Mr-OutLaw/otto/CAD/otto+Quad_4mm_v1.0.dxf

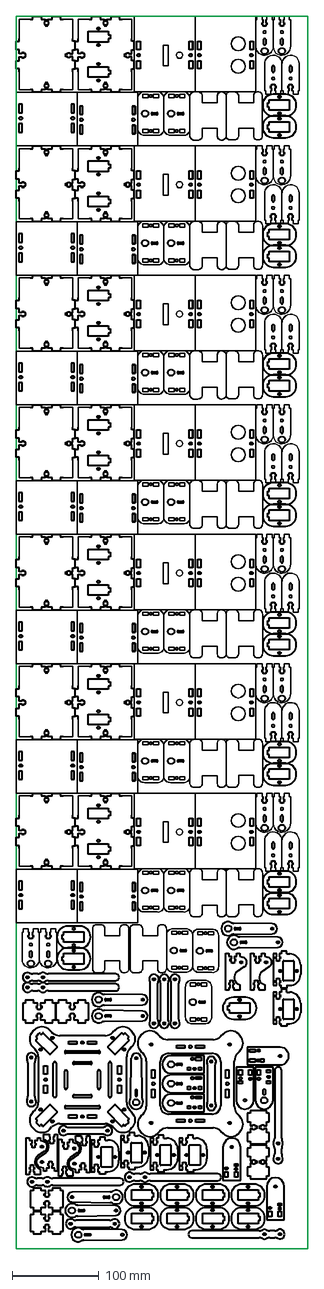
[picture p1: CAD file, 2017-09-18]
CAD/otto+Quad_4mm_v1.0.dxf
335.8 x 1420.0 mm
