Mr-OutLaw/otto/CAD/otto_4mm_v1.0.dxf

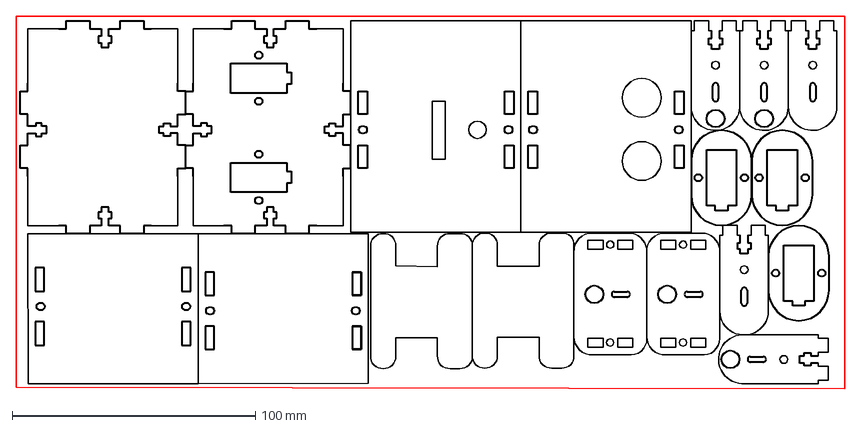
[picture p2: CAD file, 2017-09-17]
CAD/otto_4mm_v1.0.dxf
340.8 x 153.4 mm
