Mr-OutLaw/otto/CAD/otto.dxf

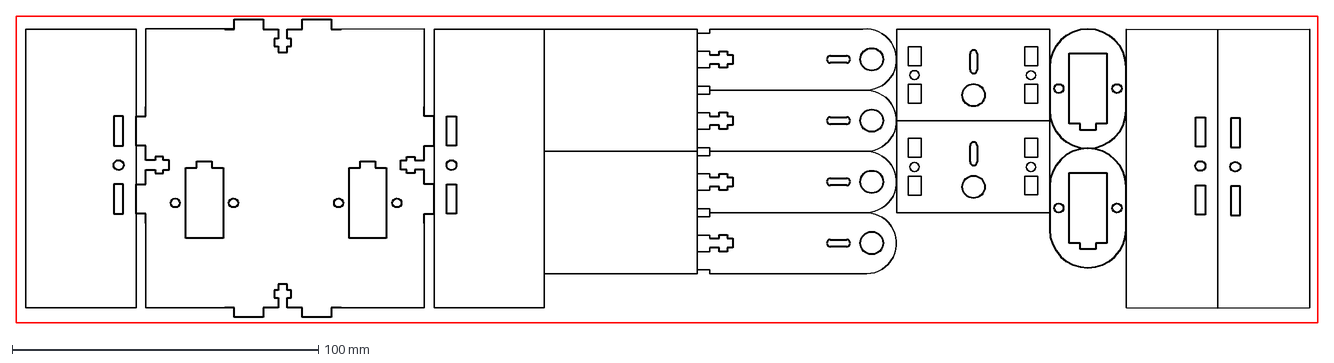
[picture p3: CAD file, 2017-09-03]
CAD/otto.dxf
425.1 x 100.0 mm
