Mr-OutLaw/otto/CAD/ott_3mmo.dxf

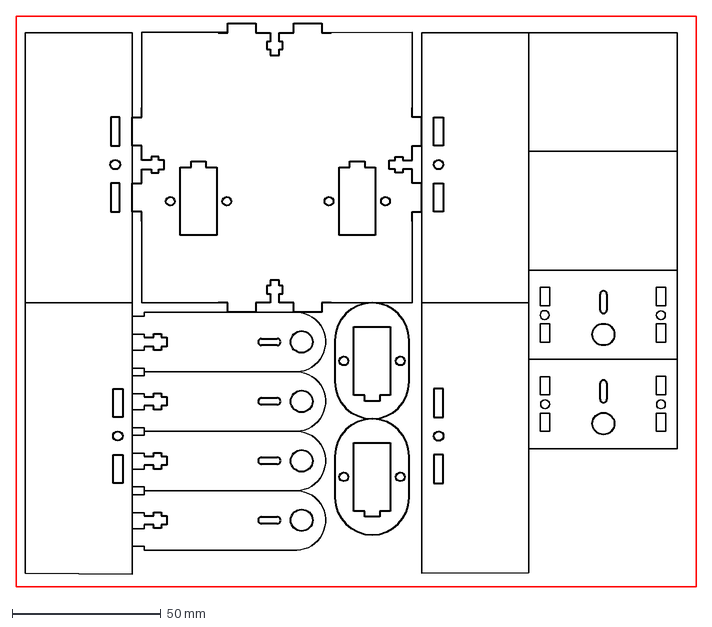
[picture p4: CAD file, 2017-09-03]
CAD/ott_3mmo.dxf
228.8 x 192.1 mm
