Mr-OutLaw/otto/OTTO+_InstructionsManual_V01_arduino.pdf

# DIY+

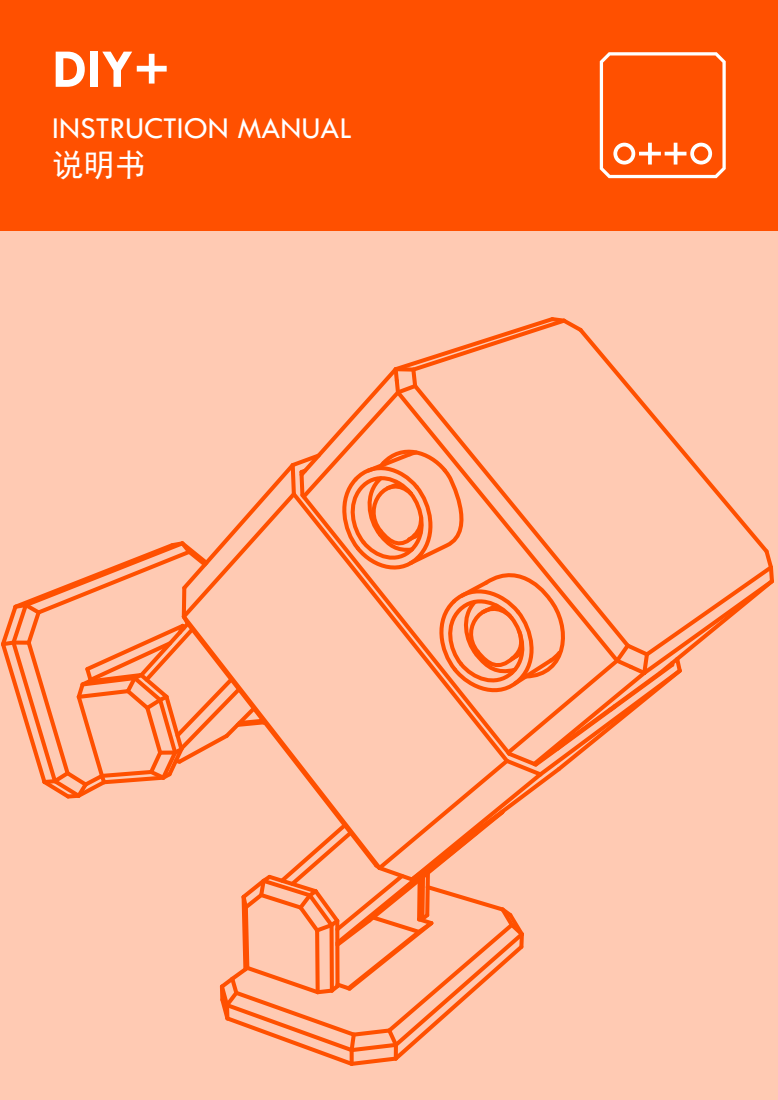
[picture p5: page 1]
INSTRUCTION MANUAL 说明书

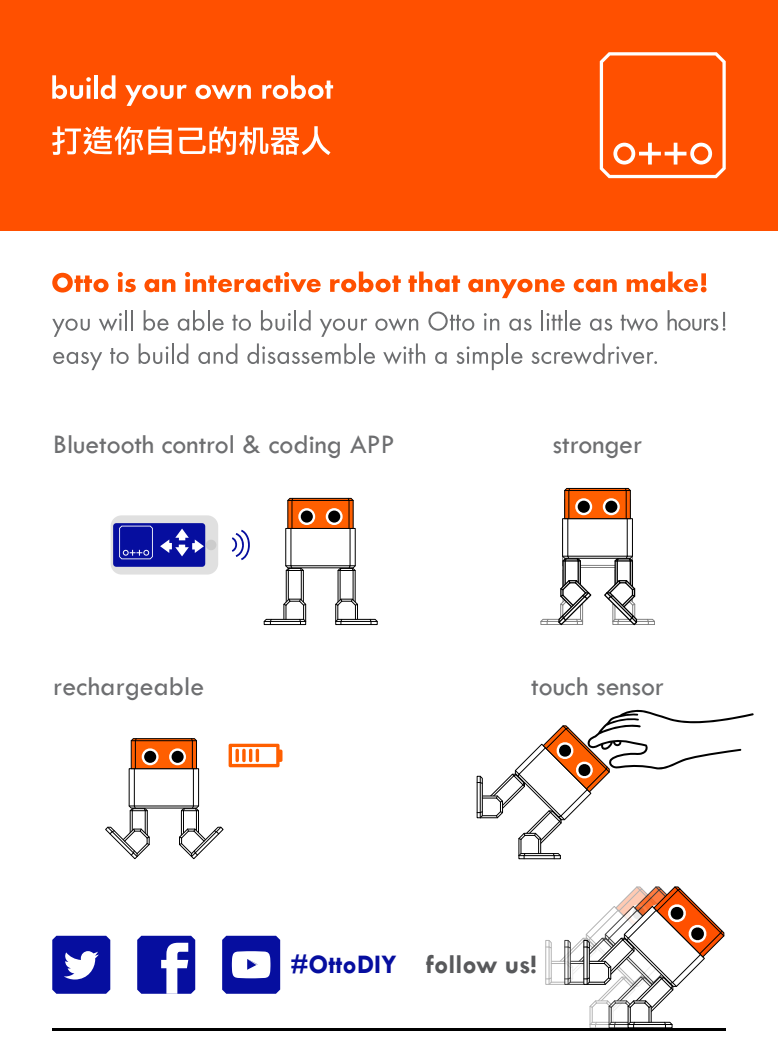
[picture p6: page 2]
rechargeable; touch sensor; stronger

Bluetooth control & coding APP

#OttoDIY follow us!

# PARTS

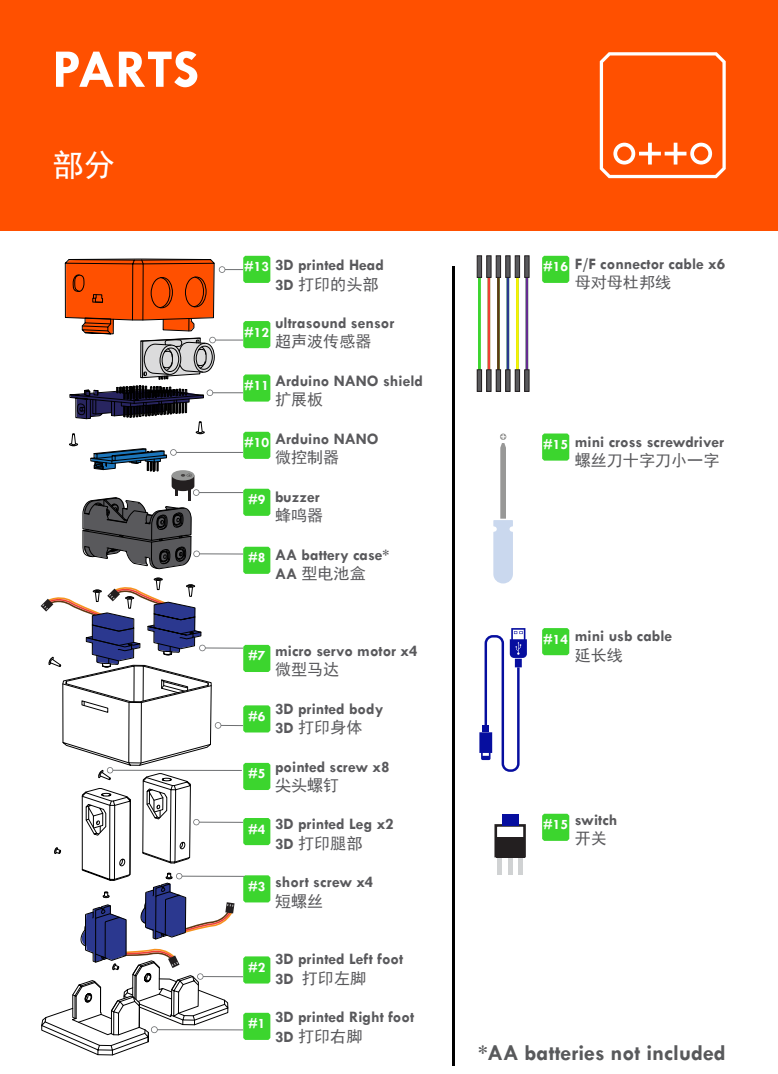
[picture p7: page 3]
#13 3D printed Head 3D 打印的头部; ultrasound sensor 超声波传感器; Arduino NANO shield 扩展板; Arduino NANO 微控制器; buzzer 蜂鸣器; micro servo motor x4 微型马达; 3D printed body 3D 打印身体; pointed screw x8 尖头螺钉; 3D printed Leg x2 3D 打印腿部; short screw x4 短螺丝; 3D printed Left foot 3D 打印左脚; #16 F/F connector cable x6 母对母杜邦线; mini cross screwdriver 螺丝刀十字刀小一字; mini usb cable 延长线; switch 开关

AA battery case*
AA 型电池盒

3D printed Right foot
3D 打印右脚 #1

*AA batteries not included

a

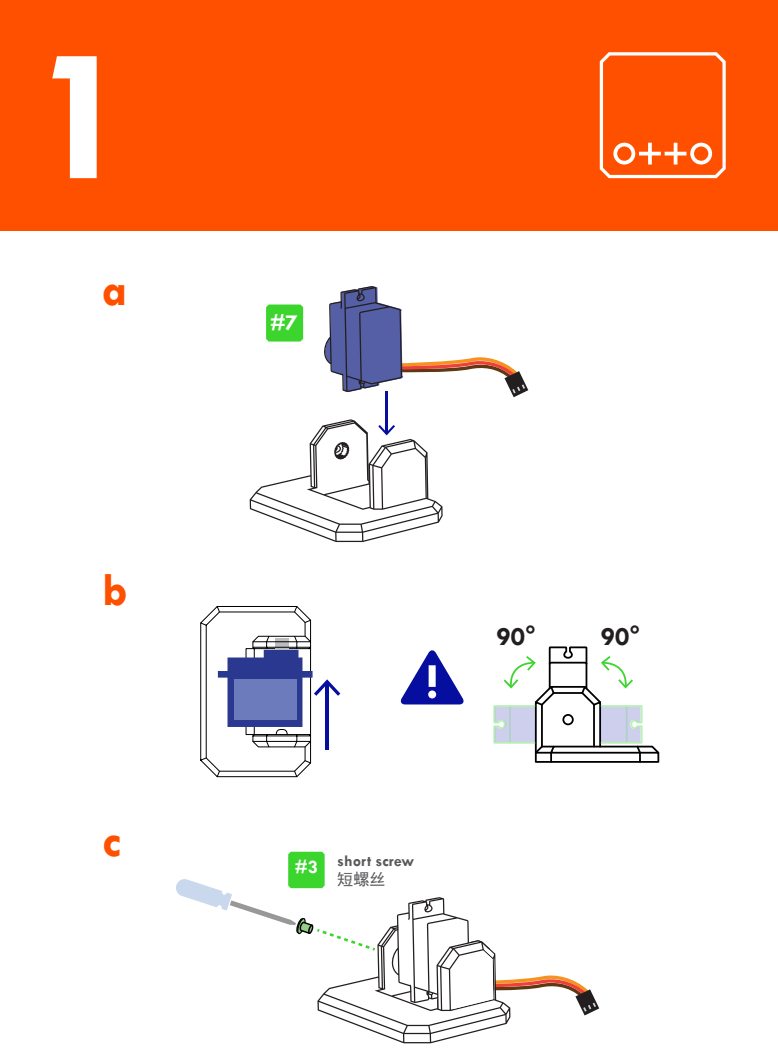
[picture p8: page 4]
short screw 短螺丝

a

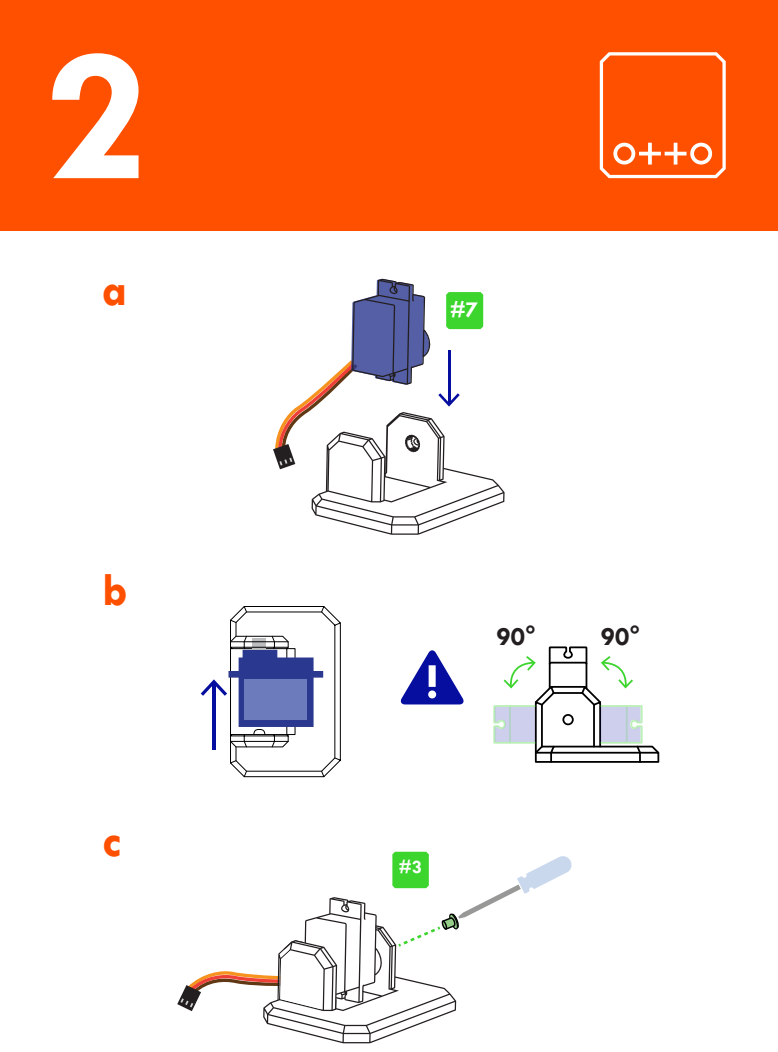
[picture p9: page 5]

a

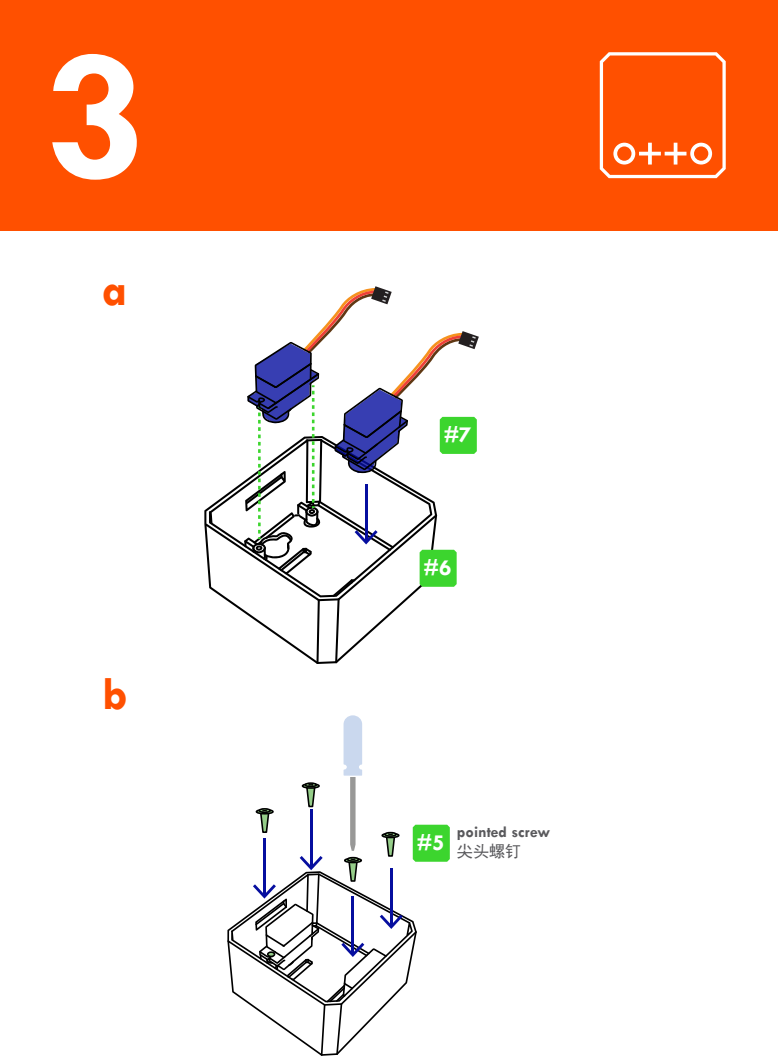
[picture p10: page 6]
#5 pointed screw 尖头螺钉

a

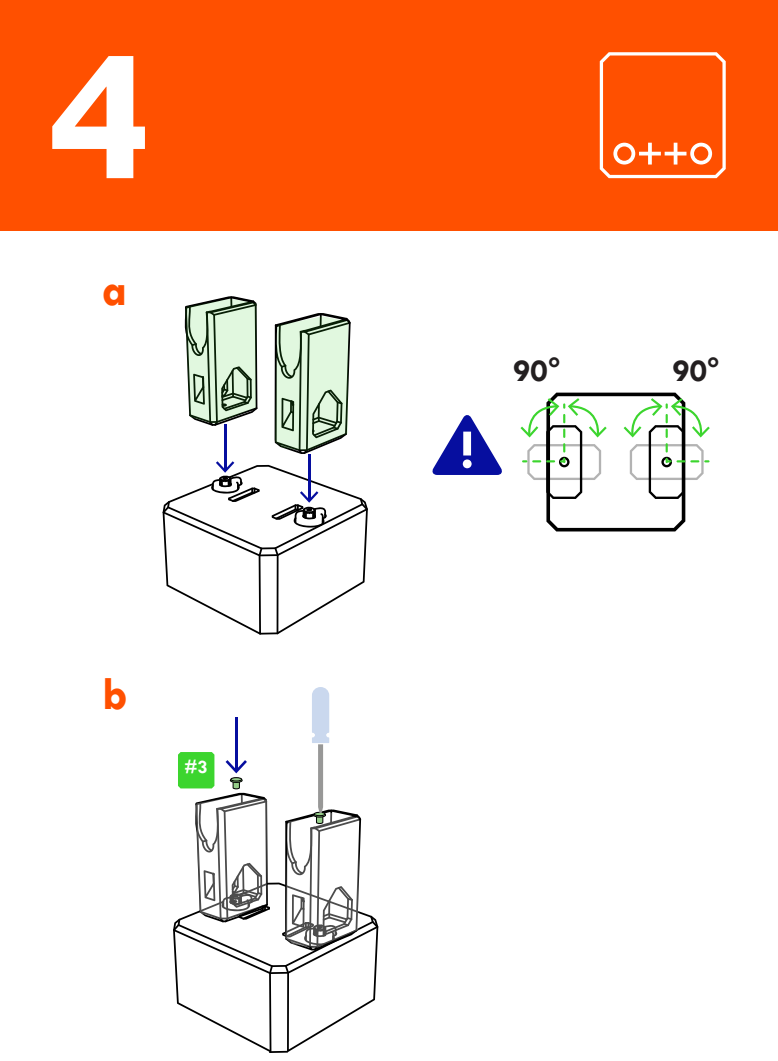
[picture p11: page 7]

ab

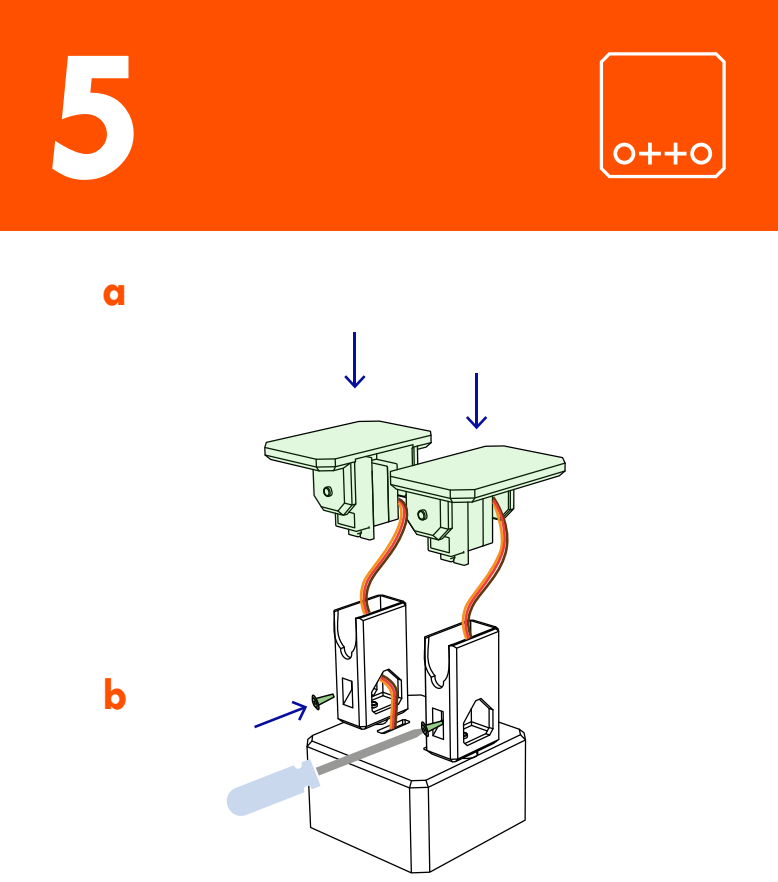
[picture p12: page 8]

ab

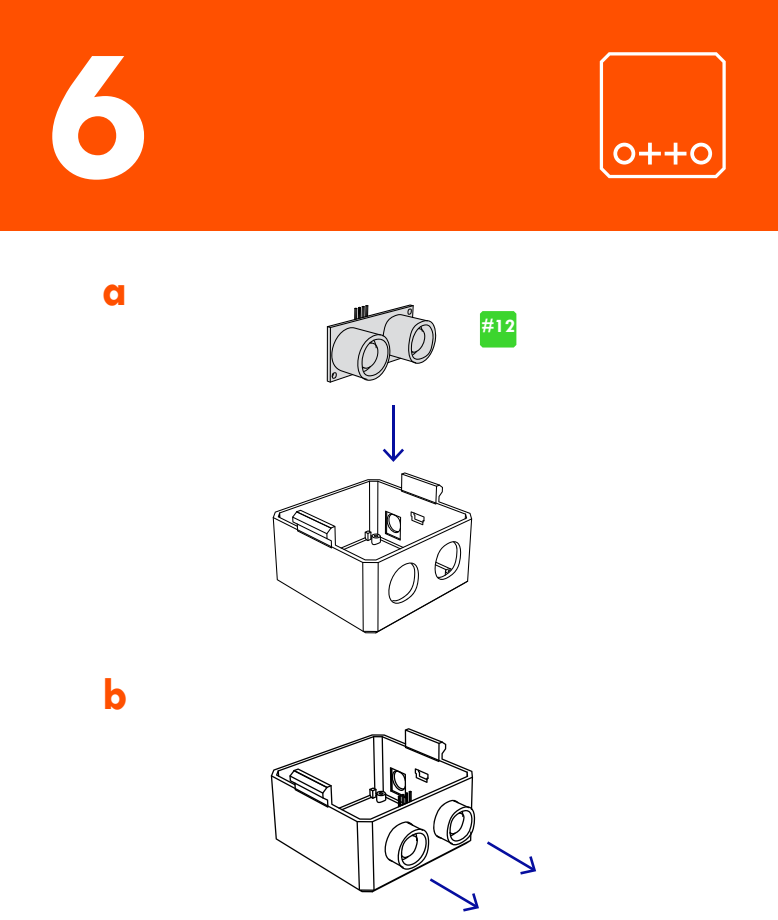
[picture p13: page 9]

ab

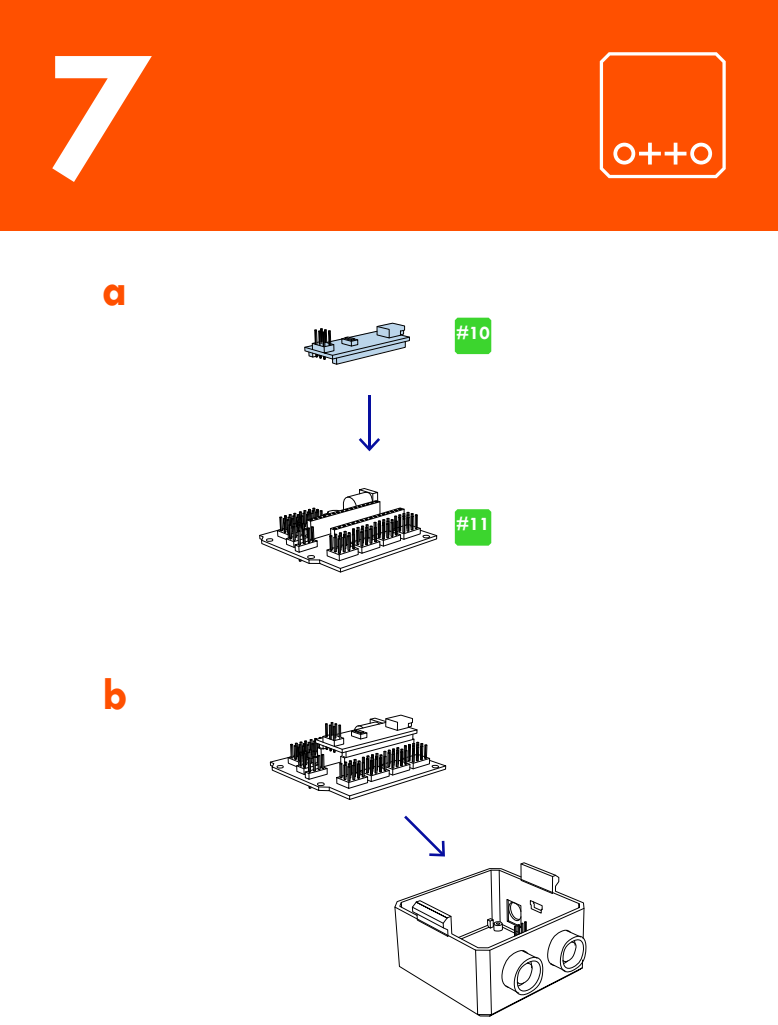
[picture p14: page 10]

ab

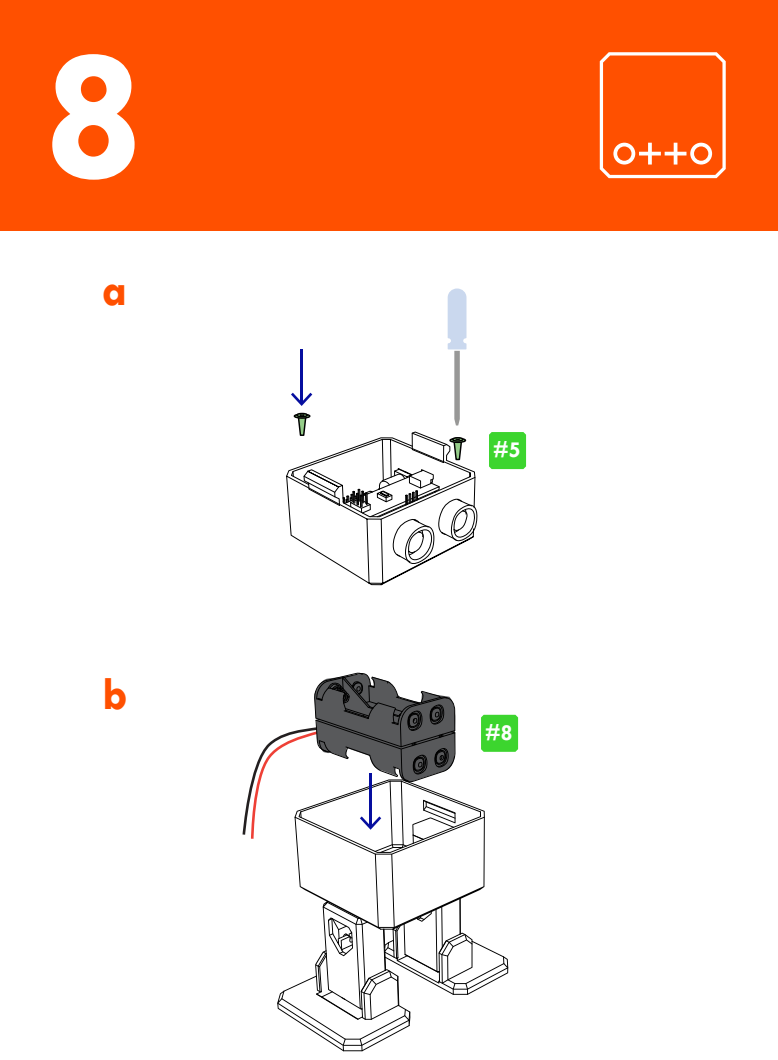
[picture p15: page 11]

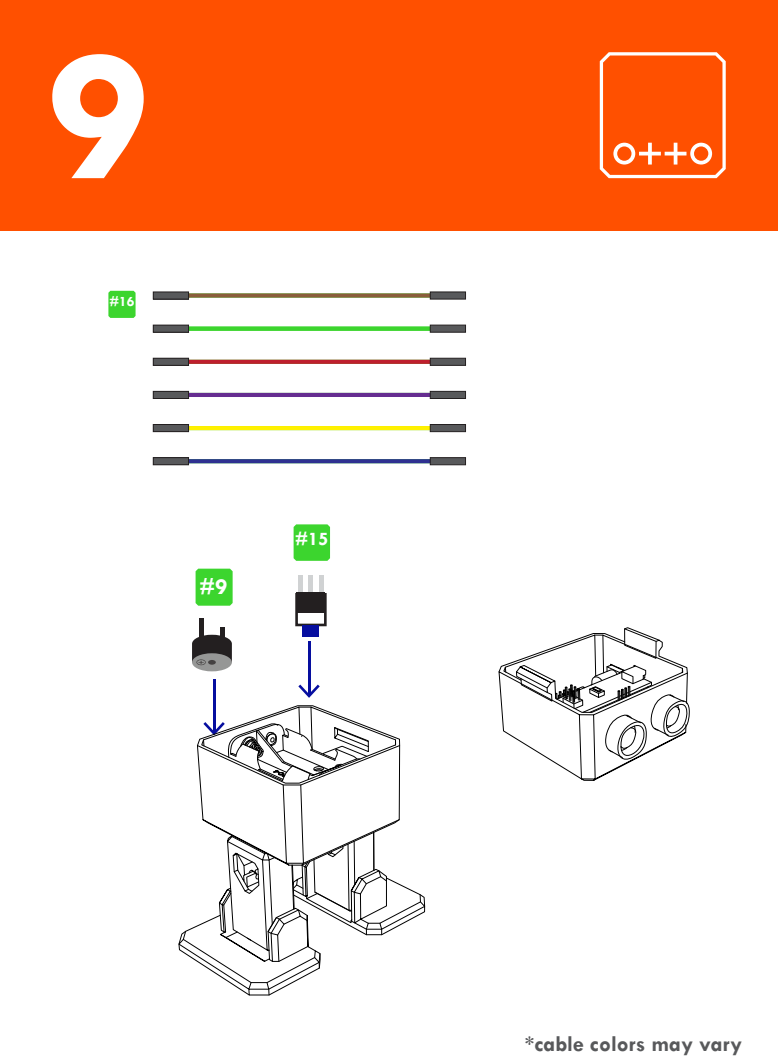
[picture p16: page 12]

*cable colors may vary

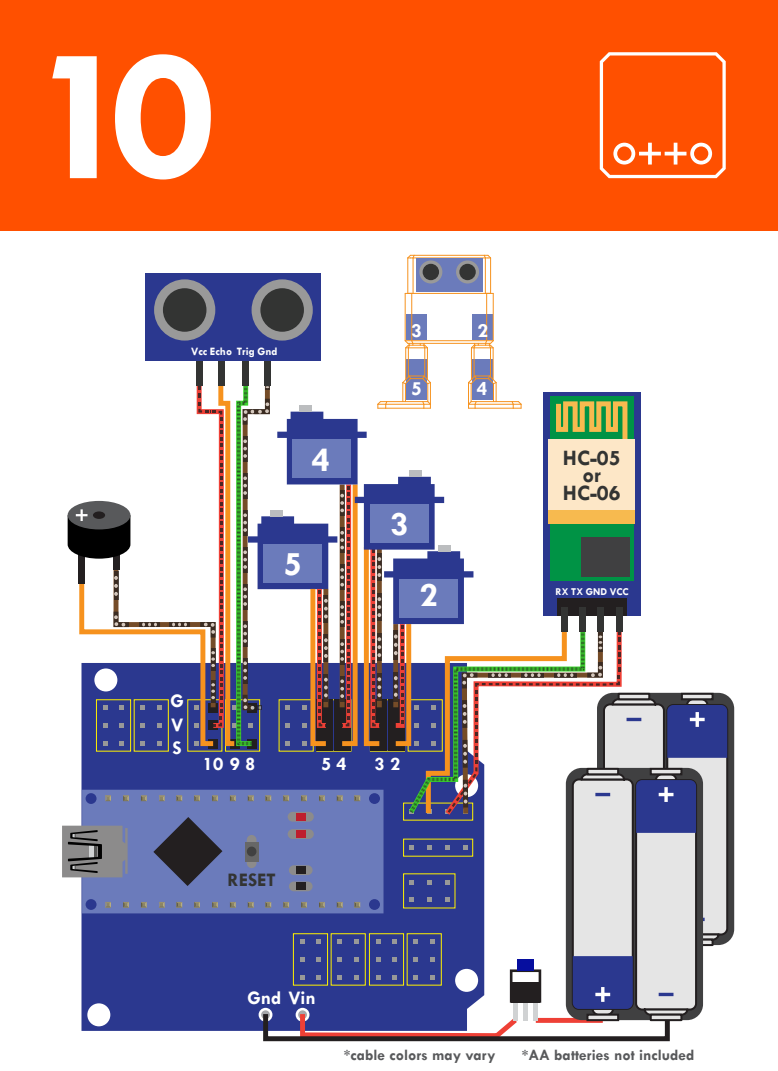
[picture p17: page 13]
RESET; Gnd Vin; *cable colors may vary; *AA batteries not included

Vcc Echo Trig Gnd

RX TX GND VCC

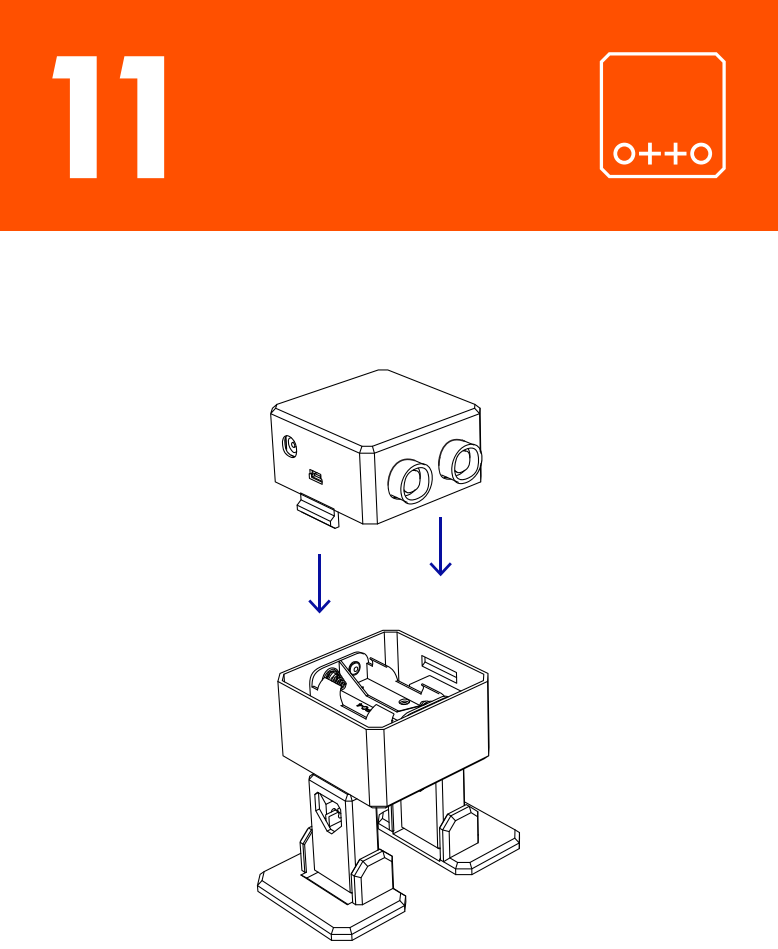
[picture p18: page 14]

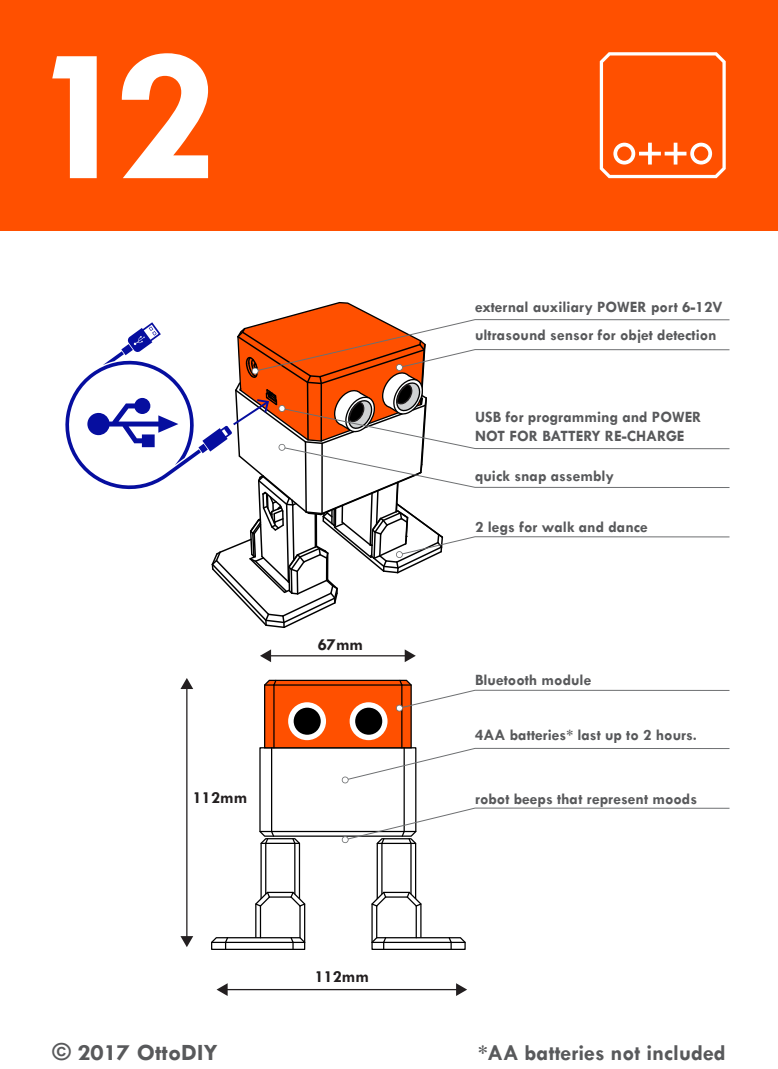
[picture p19: page 15]
Bluetooth module; © 2017 OttoDIY; *AA batteries not included

external auxiliary POWER port 6-12V
ultrasound sensor for objet detection

USB for programming and POWER
NOT FOR BATTERY RE-CHARGE

quick snap assembly

2 legs for walk and dance

4AA batteries* last up to 2 hours.

robot beeps that represent moods

# DIY+

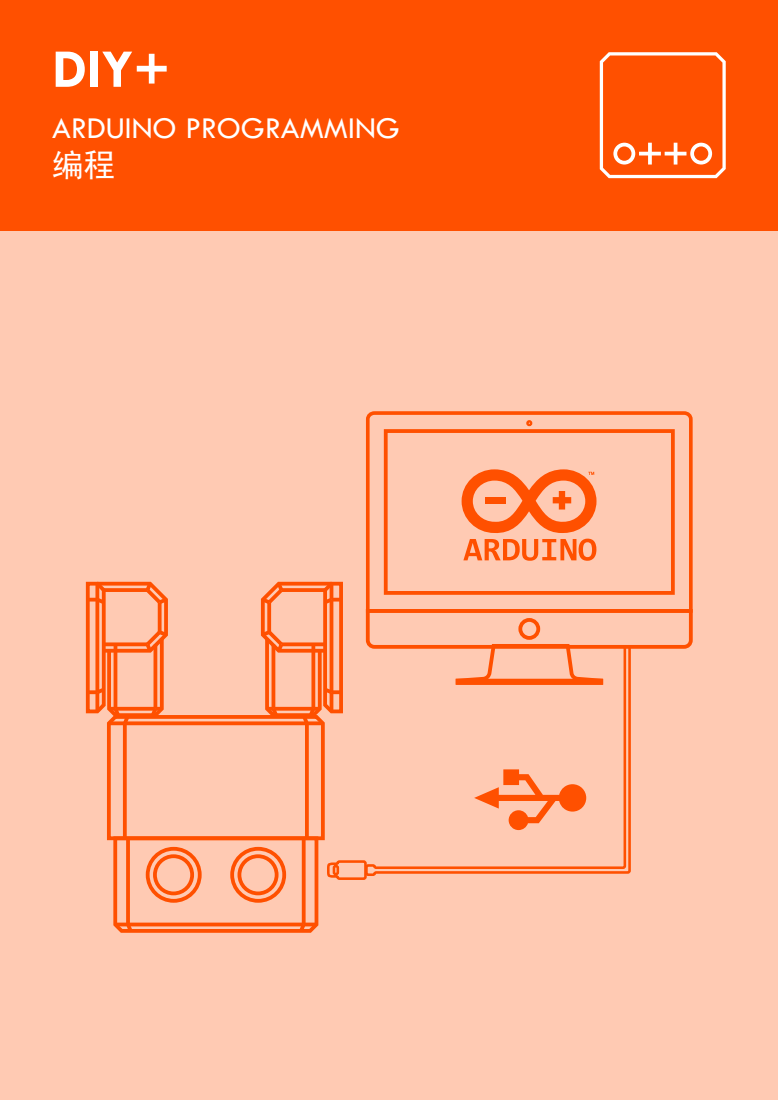
[picture p20: page 16]
ARDUINO PROGRAMMING 编程

a

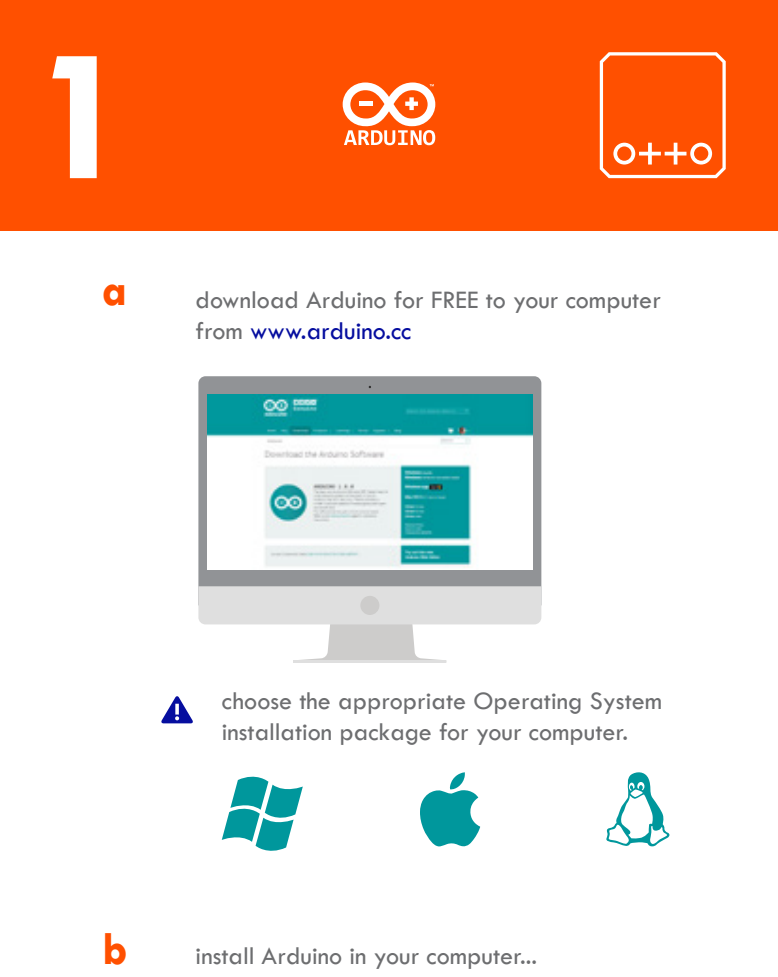
[picture p21: page 17]

download Arduino for FREE to your computer
from www.arduino.cc

choose the appropriate Operating System
installation package for your computer.

install Arduino in your computer...

a

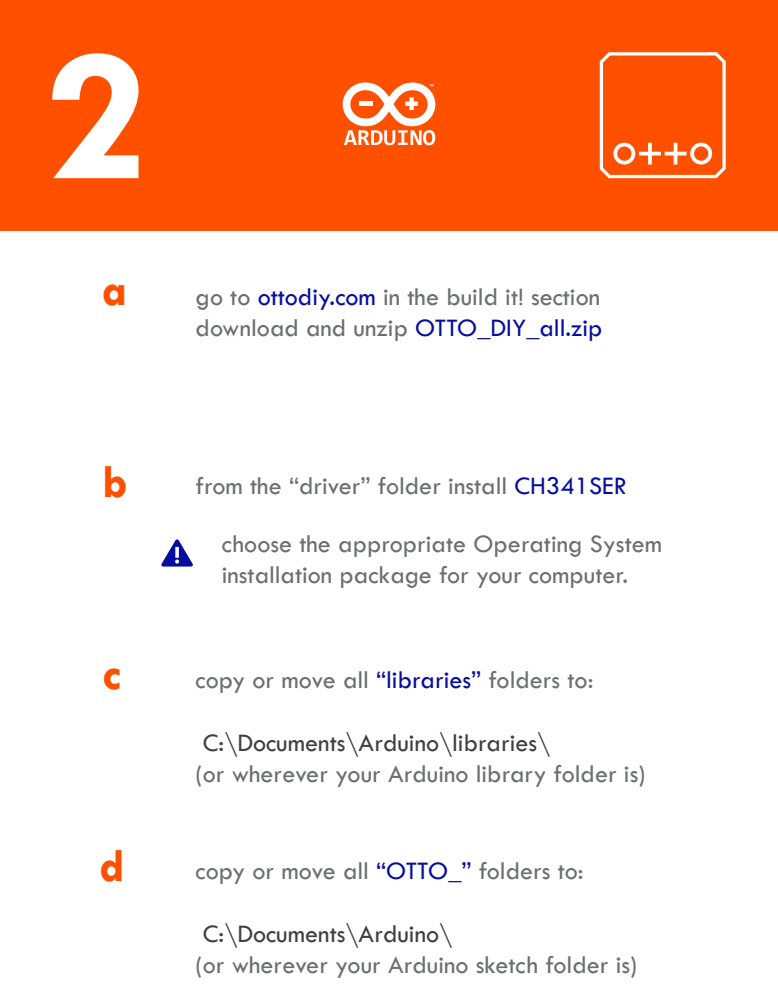
[picture p22: page 18]

go to ottodiy.com in the build it! section
download and unzip OTTO_DIY_all.zip

from the “driver” folder install CH341SER
choose the appropriate Operating System
installation package for your computer.
copy or move all “libraries” folders to:

C:\Documents\Arduino\libraries\
(or wherever your Arduino library folder is)

copy or move all “OTTO_” folders to:

C:\Documents\Arduino\
(or wherever your Arduino sketch folder is)

a

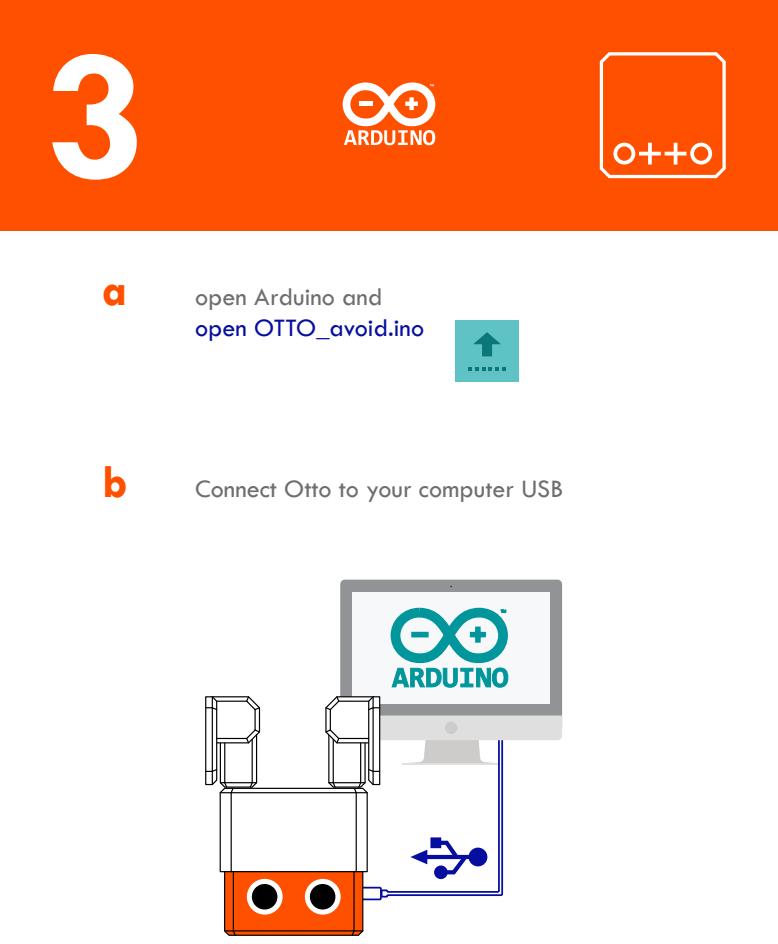
[picture p23: page 19]

open Arduino and
open OTTO_avoid.ino

Connect Otto to your computer USB

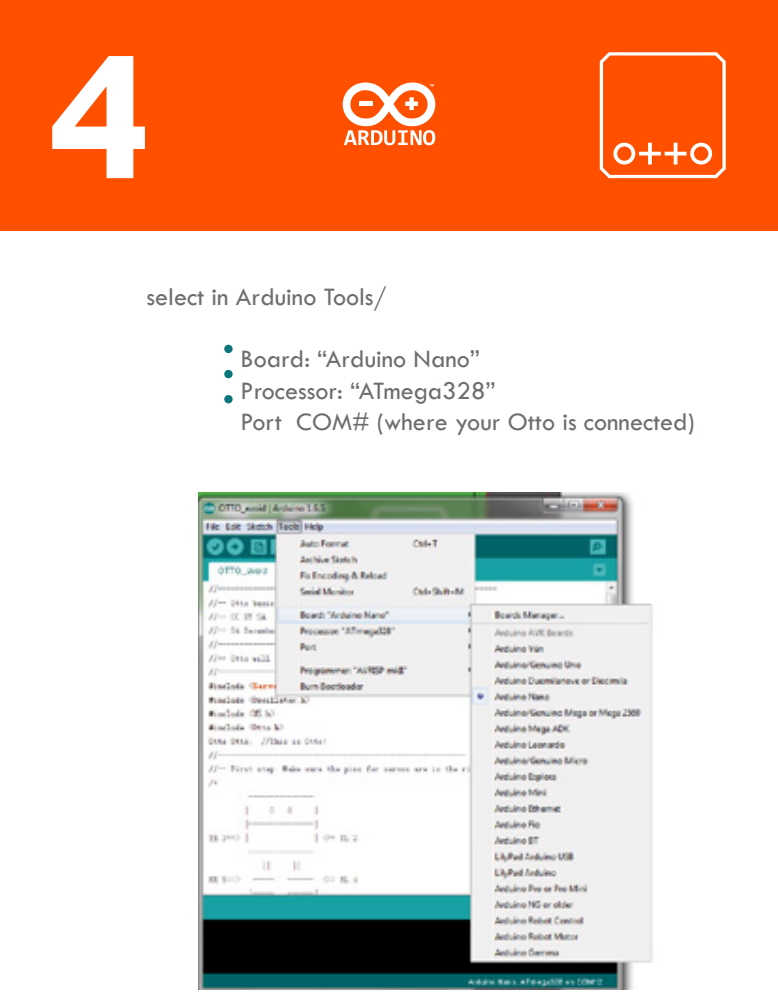
[picture p24: page 20]

select in Arduino Tools/

Board: “Arduino Nano”
Processor: “ATmega328”
Port COM# (where your Otto is connected)

a

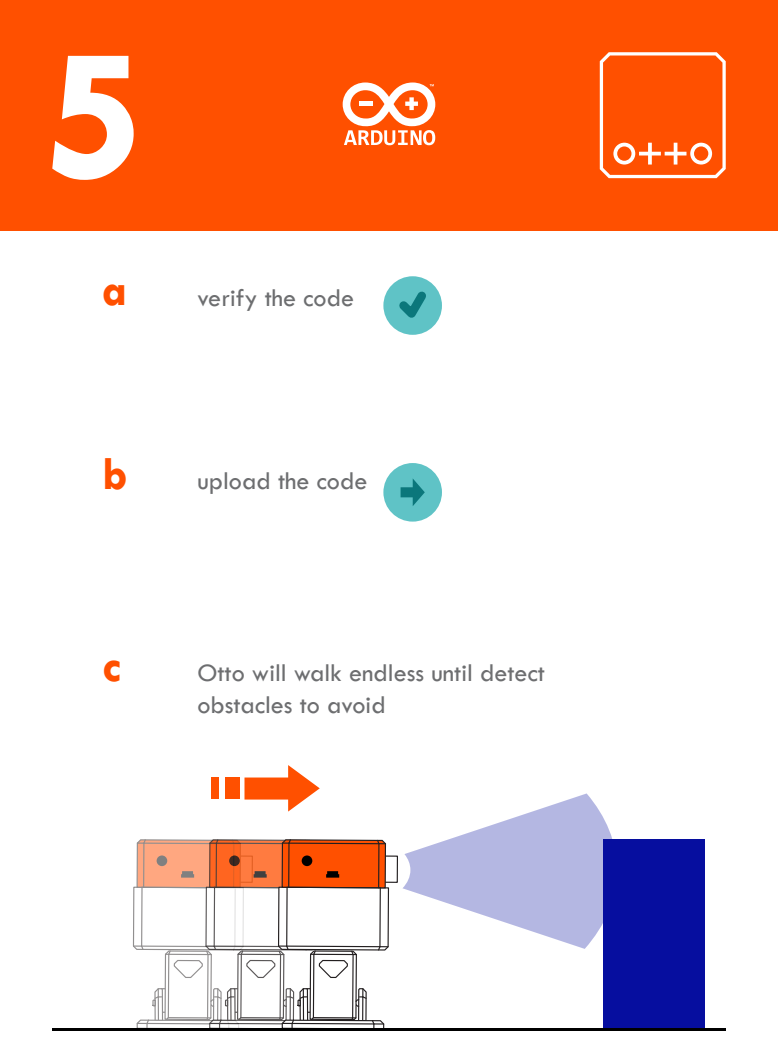
[picture p25: page 21]

verify the code

upload the code

Otto will walk endless until detect
obstacles to avoid

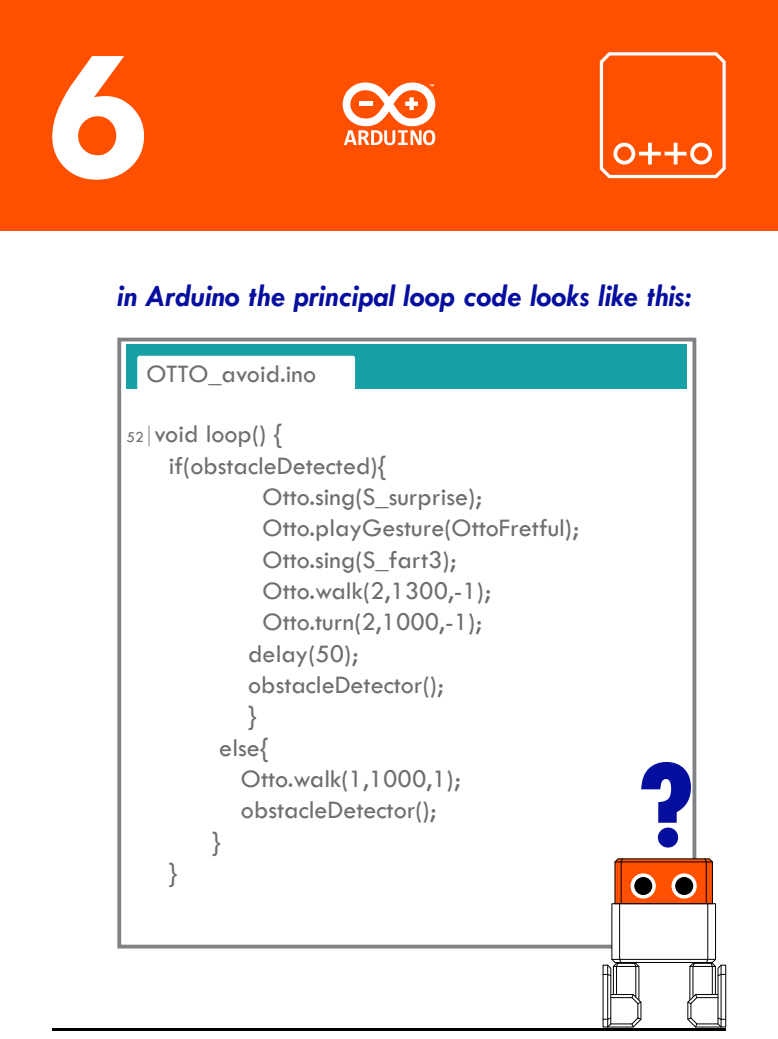
[picture p26: page 22]
void loop() { if(obstacleDetected){ Otto.sing(S_surprise); Otto.playGesture(OttoFretful); Otto.sing(S_fart3); Otto.walk(2,1300,-1); Otto.turn(2,1000,-1); delay(50); obstacleDetector(); } else{ Otto.walk(1,1000,1); obstacleDetector();; OTTO_avoid.ino

in Arduino the principal loop code looks like this:

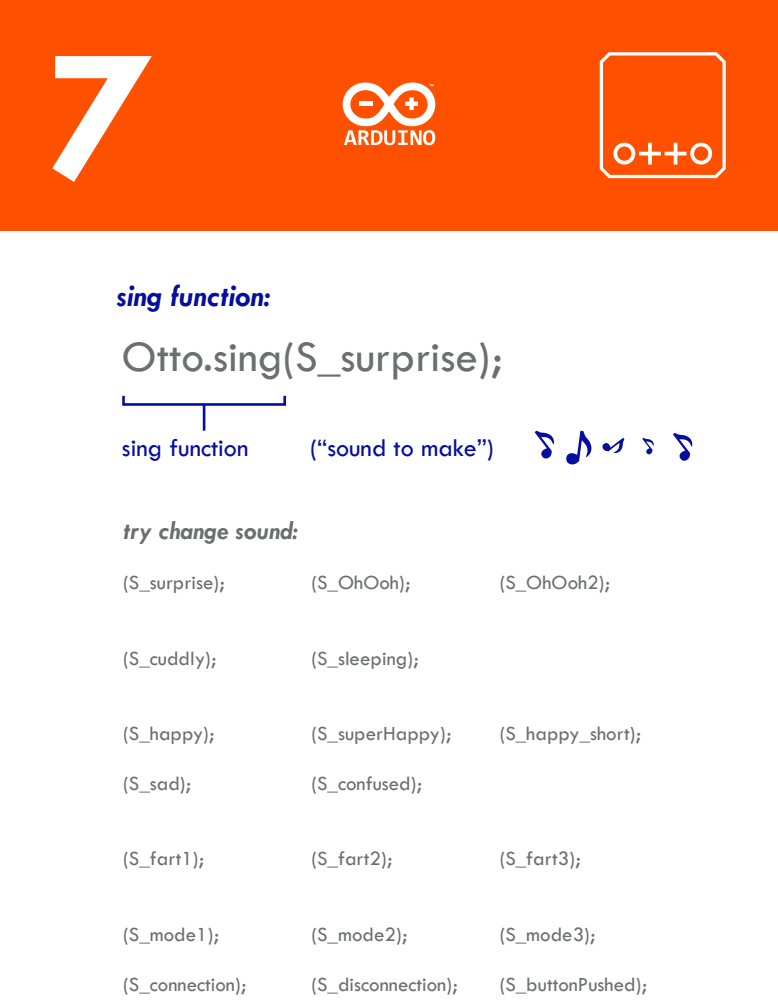
[picture p27: page 23]
(S_surprise);; (S_OhOoh);; (S_OhOoh2);; (S_cuddly);; (S_sleeping);; (S_happy);; (S_superHappy);; (S_happy_short);; (S_sad);; (S_confused);; (S_fart1);; (S_fart2);; (S_fart3);; (S_mode1);; (S_mode2);; (S_mode3);; (S_connection);; (S_disconnection);; (S_buttonPushed);; sing function: Otto.sing(S_surprise);; sing function; (“sound to make”)

try change sound:

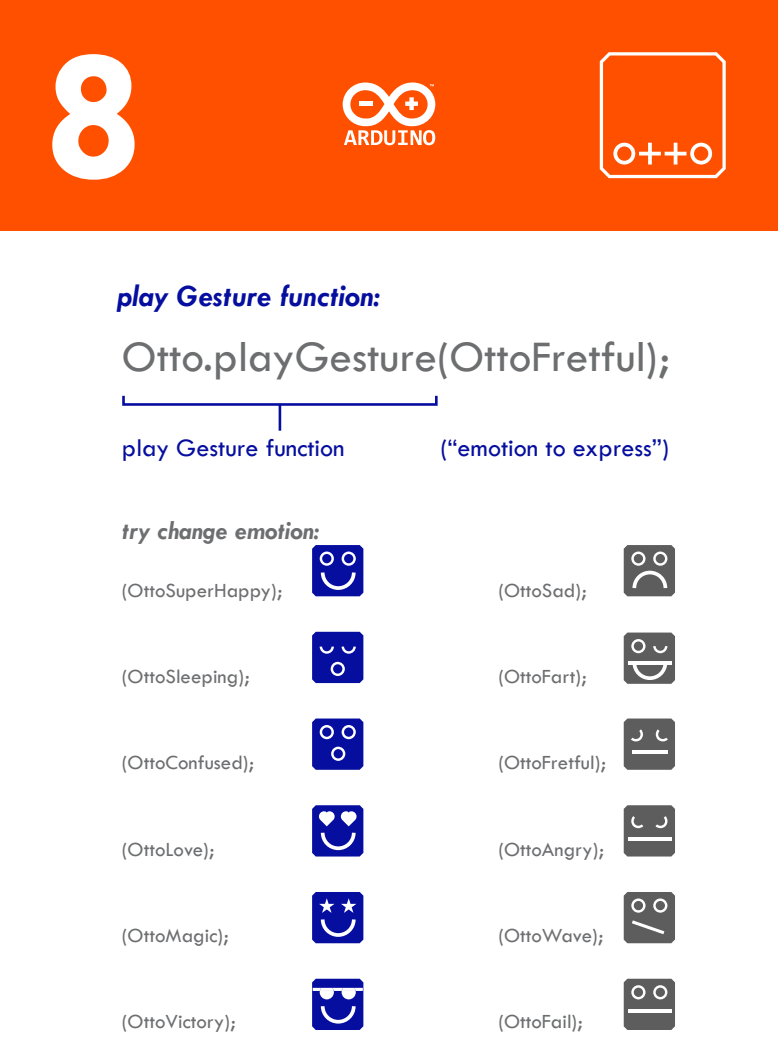
[picture p28: page 24]
(OttoSuperHappy);; (OttoSad);; (OttoSleeping);; (OttoFart);; (OttoConfused);; (OttoFretful);; (OttoLove);; (OttoAngry);; (OttoMagic);; (OttoWave);; (OttoVictory);; (OttoFail);; play Gesture function; (“emotion to express”)

play Gesture function:
Otto.playGesture(OttoFretful);

try change emotion:

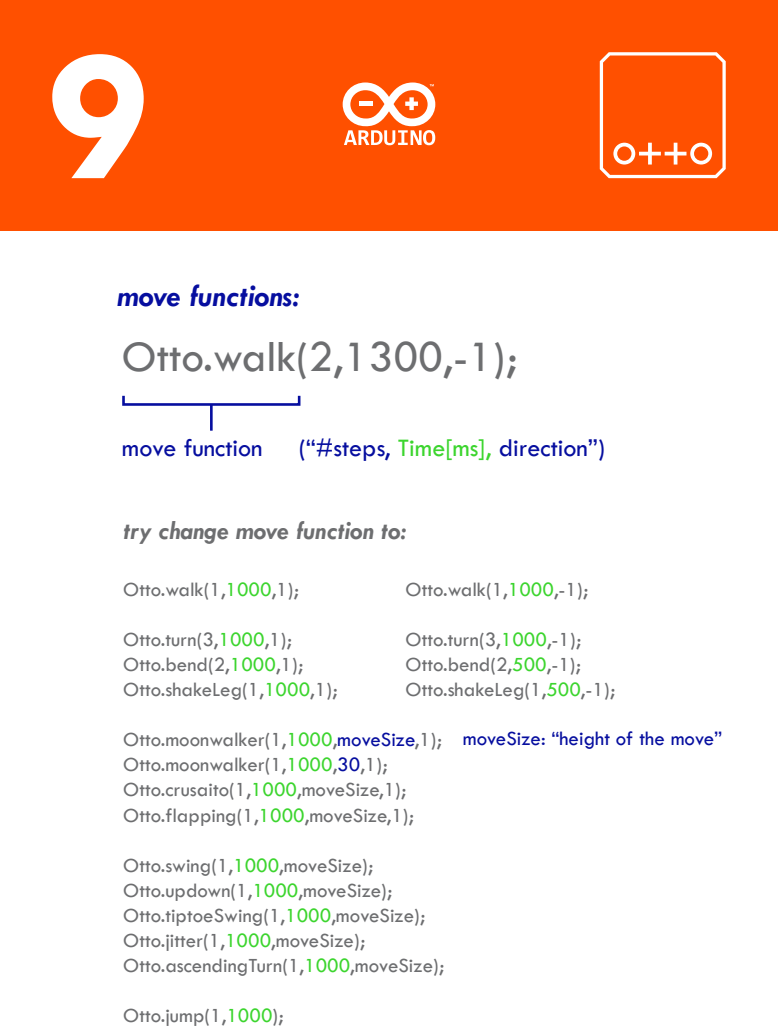
[picture p29: page 25]
move functions: Otto.walk(2,1300,-1);; Otto.walk(1,1000,1);; Otto.walk(1,1000,-1);; Otto.turn(3,1000,1);; Otto.turn(3,1000,-1);; Otto.bend(2,1000,1);; Otto.bend(2,500,-1);; Otto.shakeLeg(1,1000,1);; Otto.shakeLeg(1,500,-1);; Otto.jump(1,1000);

move function (“#steps, Time[ms], direction”)

try change move function to:

Otto.moonwalker(1,1000,moveSize,1);
Otto.moonwalker(1,1000,30,1);
Otto.crusaito(1,1000,moveSize,1);
Otto.flapping(1,1000,moveSize,1);

moveSize: “height of the move”

Otto.swing(1,1000,moveSize);
Otto.updown(1,1000,moveSize);
Otto.tiptoeSwing(1,1000,moveSize);
Otto.jitter(1,1000,moveSize);
Otto.ascendingTurn(1,1000,moveSize);

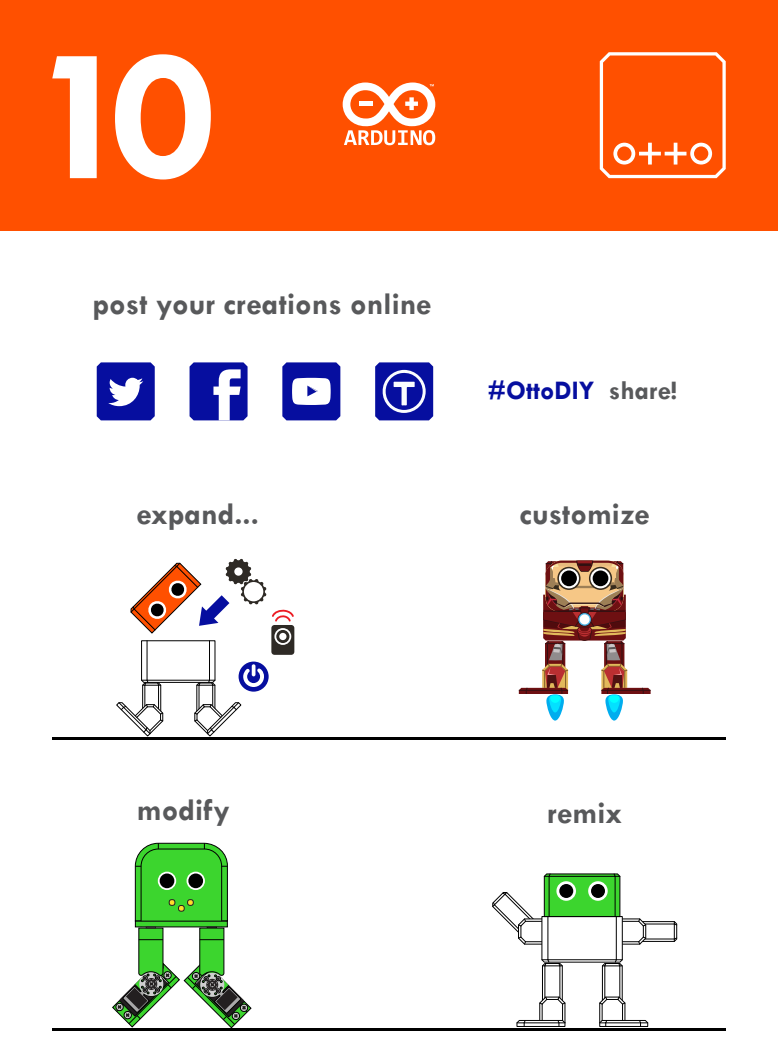
[picture p30: page 26]
#OttoDIY share!; remix; expand...; customize; modify

post your creations online

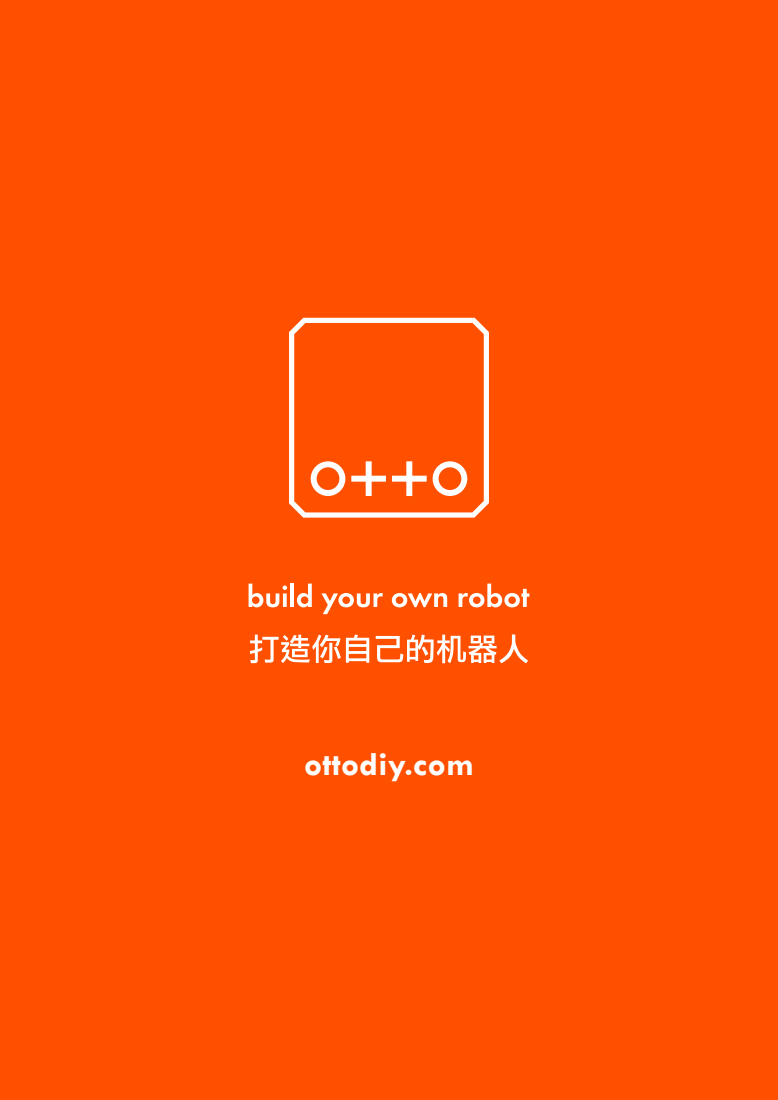
[picture p31: page 27]
ottodiy.com
